partio-scout/scoms-tacnpr/(notices)

Notices in the files:
TACNPR.kicad_pcb:
Licensed under the TAPR OHL
License: TAPR OHL
